ajsike2310/PROJECT-IKRU-The-Intelligent-Kinematic-Robot-/ESP32.jpeg

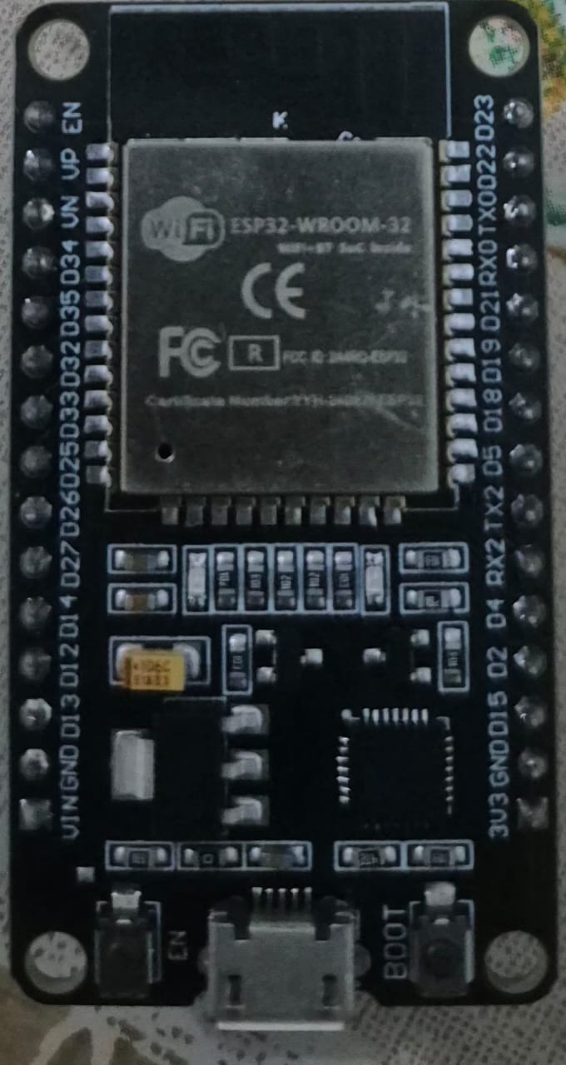
ESP32.jpeg
