ajsike2310/PROJECT-IKRU-The-Intelligent-Kinematic-Robot-/L293Dmotordriver.jpeg

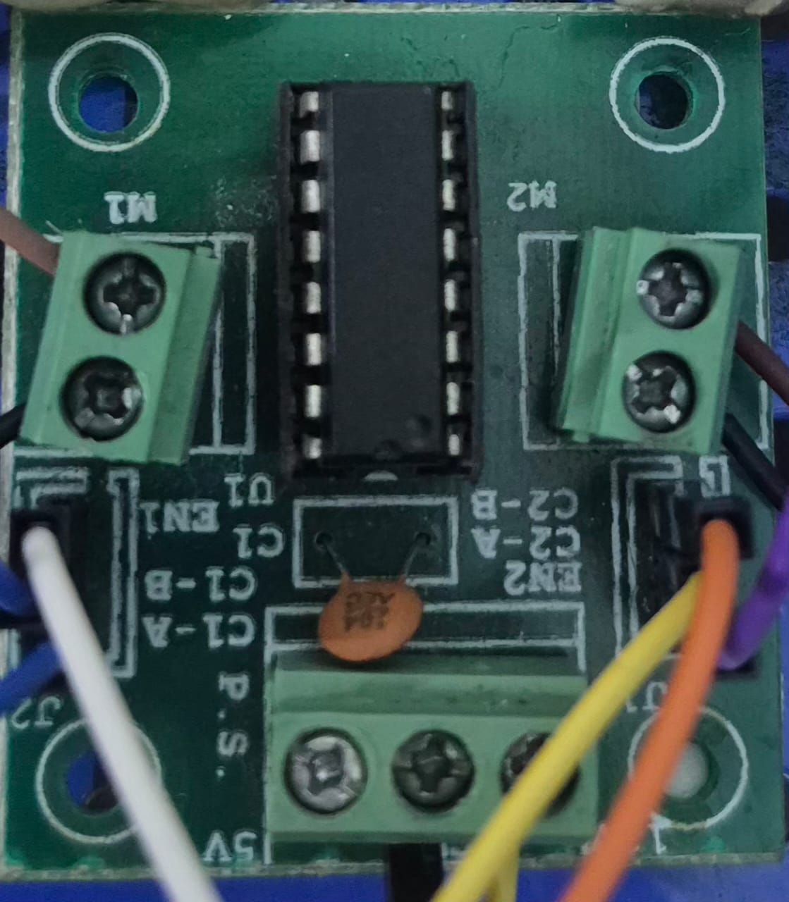
L293Dmotordriver.jpeg
