ajsike2310/PROJECT-IKRU-The-Intelligent-Kinematic-Robot-/(commit log)

2026-08-11 display and motors phases 1
2026-08-12 feat: replace custom eye drawing with esp32-eyes Face library, add 18 emotions
    - Replaced hand-drawn OLED eye code with esp32-eyes animated Face library
    - Added all 29 library source files (Face, Eye, FaceExpression, etc.)
    - Added 18 callable emotion functions: normal, happy, glee, sad, worried,
    focused, annoyed, surprised, skeptic, frustrated, unimpressed, sleepy,
    suspicious, squint, angry, furious, scared, awe
    - Ported speech text scroll rendering from Adafruit_SSD1306 to U8g2
    - Updated robot.py with all 18 emotion methods
    - Updated chat.py emotion_functions dict and SYSTEM_PROMPT for new emotions
    - Requires U8g2 library installed in Arduino IDE
2026-08-13 feat: Add 10-second emotion timeout in ESP32 firmware
2026-08-13 fix: Remove oledMessage calls from motor functions to fix display conflict
2026-08-22 Implement IKRU Vision system with ESP32-CAM firmware, vision pipeline, and LLM context integration
2026-08-22 Fix esp32_cam.ino compilation issues on Arduino Core 3.x
2026-08-22 feat: Add VLM visual Q&A + full repo cleanup
    - vision.py: Add clean frame buffer (latest_clean_frame) before annotation drawing
    - vision.py: Add thread-safe get_latest_frame(clean=True) for VLM-ready JPEG bytes
    - chat.py: Add describe_scene_vlm() helper querying llava:7b via ollama.generate()
    - chat.py: Add VISUAL_KEYWORDS trigger for on-demand VLM scene description
    - chat.py: VLM description injected into Qwen context only on visual questions
    - Repo: Remove src/esp32-eyes-main/ (renamed to src/esp32_eyes/)
    - Repo: Move hardware images to docs/images/
    - Repo: Move master_project_prompt.md to .agents/
    - Repo: Delete empty src/__init__.py
    - Repo: Update .gitignore (src/models/, pycache, AI con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
2026-08-22 fix: Suppress vision stream log spam and improve stability
    - Only log on state transitions (connected/disconnected), not every retry
    - Increase urlopen timeout from 5s to 15s for slow WiFi/ESP32 boot
    - Increase chunk read size from 2048 to 8192 for better MJPEG throughput
    - Add buffer overflow guard (1MB cap) to prevent memory growth on stalls
    - Add empty JPEG guard (< 100 bytes) before imdecode to prevent OpenCV assertion
    - Exponential backoff on reconnect: 2 -> 4 -> 8 -> 10s max
    - Add b > a guard to prevent EOI-before-SOI slice corruption
2026-08-22 fix: Eliminate vision log interference + fix ESP32-CAM firmware
    Python:
    - vision.py: Add thread-safe log_queue + _vlog() + flush_logs()
    All background thread prints now go to queue, not stdout
    - chat.py: Call vision.flush_logs() before each input() prompt
    Vision messages now appear cleanly between prompts, never mid-typing
    ESP32-CAM firmware:
    - Move #include soc/soc.h and soc/rtc_cntl_reg.h to file top
    (were wrongly placed inside setup() body -- invalid C++)
    - pin_sscb_sda/pin_sscb_scl -> pin_sda/pin_scl (Core 3.x API)
    - Remove conditional CAMERA_GRAB_LATEST ifdef, use unconditionally
    - Add vTaskDelay(10ms) in stream loop to prevent watchdog reset
    - Add WiFi connection timeout (30 att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
2026-08-22 Fix camera vision stream timeouts and OpenCV freezing issues
2026-08-24 feat: Restructure project into modular software/firmware/tests layout and update to DRV8833 motor driver
2026-08-25 feat: Integrate R2-D2 Sonic Emotion system, sentence prosody, and ESP32-CAM Head Unit firmware
2026-08-25 fix: Disable WiFi sleep mode and enable auto-reconnect on Body ESP32 with non-blocking send
2026-08-25 chore: Remove redundant/obsolete firmware sketches and prototype test files
2026-09-05 feat: Integrate natural voice TTS over I2S (MAX98357A) on ESP32 body controller
2026-09-11 feat: IKRU dashboard UI with chat, camera, WiFi, TTS, and audio settings
2026-09-11 feat: live network info panel — real SSID, signal, server IP, robot/cam reachability
2026-09-12 feat: Add startup config prompts and pre-generated audio fillers
    - Added Robot IP and Wi-Fi credential prompts to run.py
    - Automatically connect to ESP32 and send SET_WIFI command to switch networks
    - Patched perth watermarker crash on Windows CPU
    - Pre-generate Chatterbox thinking filler audio phrases on startup to avoid LLM blocking
    - Enhanced Edge-TTS fallback stability in chat loop
    - Saved configs to config.json
2026-09-18 Update firmware with GET_DISTANCE and adjust ultrasonic testing
2026-09-19 Add idle behavior, recorded emotion sequences, ultrasonic proximity reactions, auto-resume movement, and autonomous brain
2026-09-25 feat: enhance mic controller with VAD, add net discovery and bringup, update firmware and motor diagnostic tests
2026-10-14 feat: add offline faster-whisper STT, terminal UI mascot and system HUD, and refine autonomous brain grounding
