ajsike2310/PROJECT-IKRU-The-Intelligent-Kinematic-Robot-/(notices)

Notices in the files:
firmware/controller/Face.cpp:
This program is free software: you can redistribute it and/or modify it under the terms of the GNU Affero General Public License as published by
the Free Software Foundation, either version 3 of the License, or (at your option) any later version.
README.md:
License: MIT
